andrewge8622/PCB_Coil_WPT/Hardware/Inductor Coil 2L/Renders/Inductor Coils.png

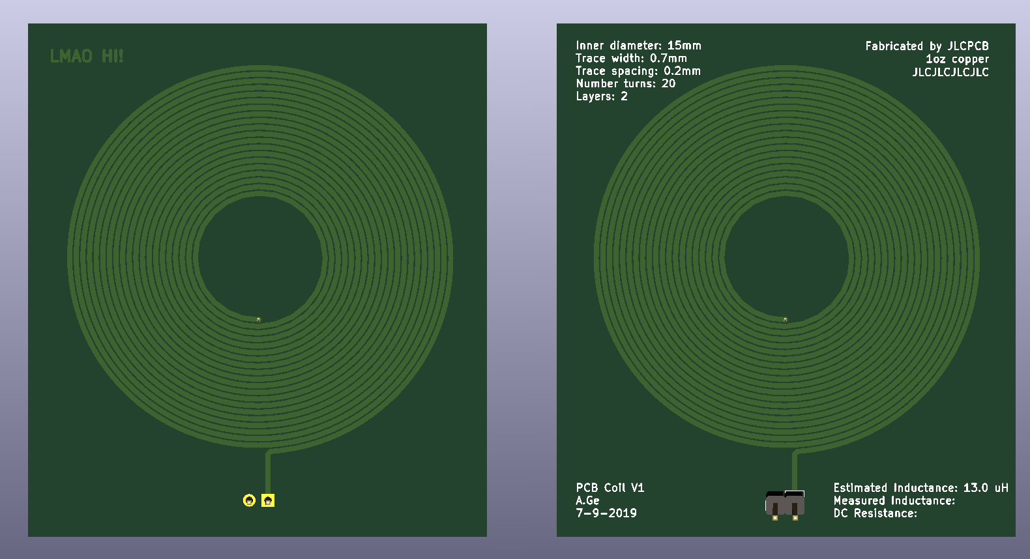
Hardware/Inductor Coil 2L/Renders/Inductor Coils.png
