andrewge8622/PCB_Coil_WPT/Hardware/Coil Driver/STEP models/WE-TPC_4818 (rev1).stp

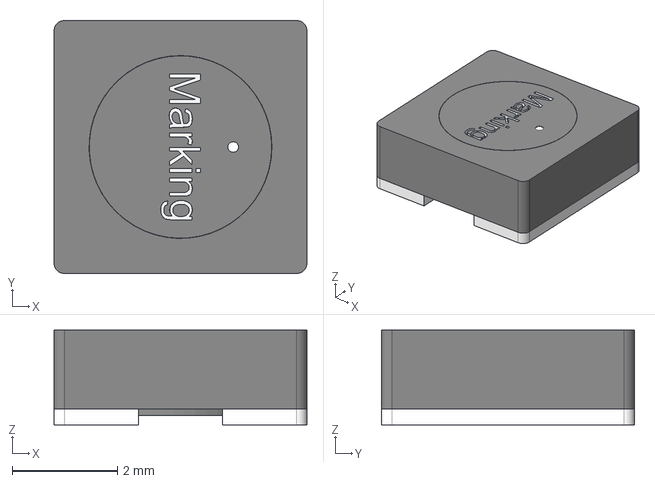
[picture p2: CAD file, 2020-12-25]
Hardware/Coil Driver/STEP models/WE-TPC_4818 (rev1).stp
4.80 x 4.80 x 1.80 mm
