andrewge8622/PCB_Coil_WPT/Hardware/WPT Receiver/STEP models/ECS-80-18-30-JGN-TR.STEP

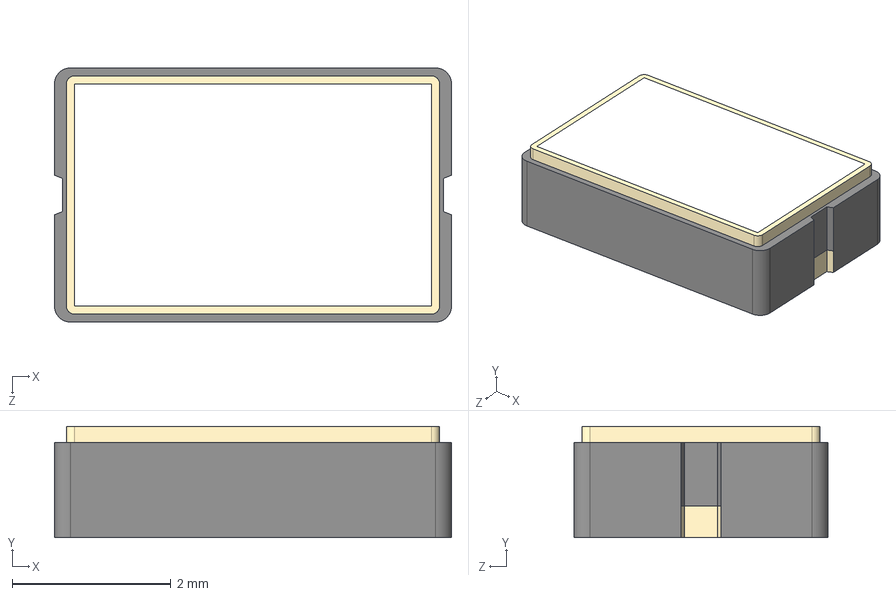
[picture p3: CAD file, 2020-12-27]
Hardware/WPT Receiver/STEP models/ECS-80-18-30-JGN-TR.STEP
5.00 x 1.40 x 3.20 mm
