andrewge8622/PCB_Coil_WPT/Hardware/Coil Driver/STEP models/CUI_DEVICES_PJ-102AH.step

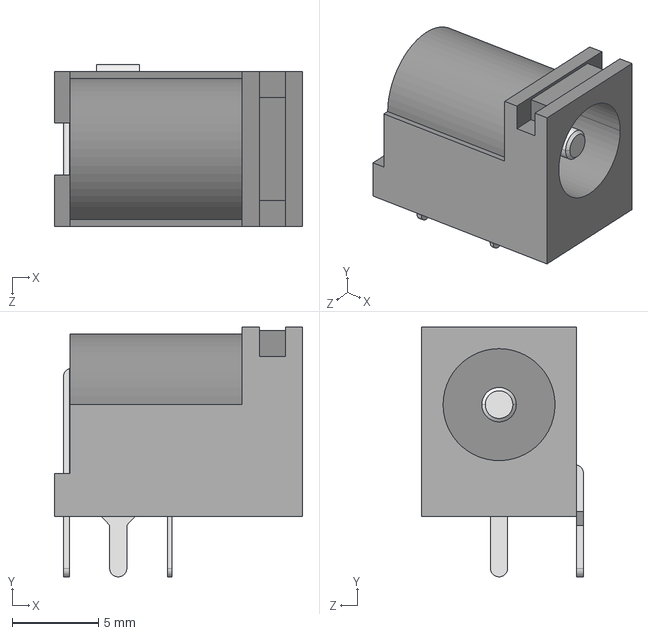
[picture p4: CAD file, 2020-12-25]
Hardware/Coil Driver/STEP models/CUI_DEVICES_PJ-102AH.step
14.4 x 14.5 x 9.40 mm
