andrewge8622/PCB_Coil_WPT/Hardware/WPT Receiver/STEP models/PTS647SN50SMTR2LFS.stp

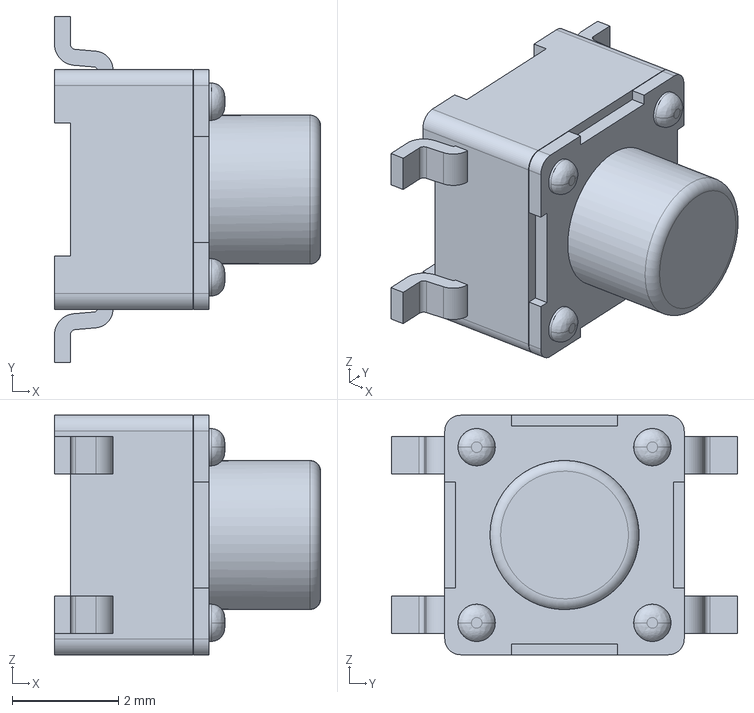
[picture p5: CAD file, 2020-12-25]
Hardware/WPT Receiver/STEP models/PTS647SN50SMTR2LFS.stp
5.00 x 6.50 x 4.50 mm
