andrewge8622/PCB_Coil_WPT/Hardware/Coil Driver/STEP models/ABM3B.STEP

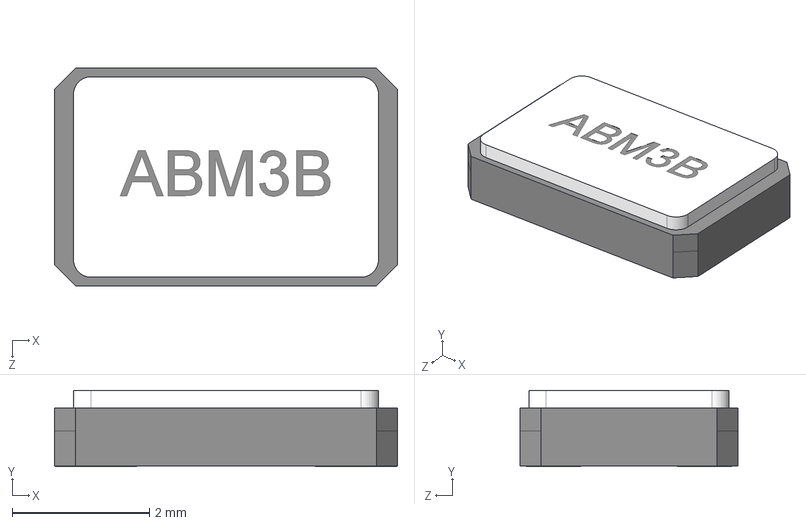
[picture p6: CAD file, 2020-12-25]
Hardware/Coil Driver/STEP models/ABM3B.STEP
5.00 x 1.11 x 3.18 mm
