andrewge8622/PCB_Coil_WPT/Hardware/Coil Driver/STEP models/16-2.STEP

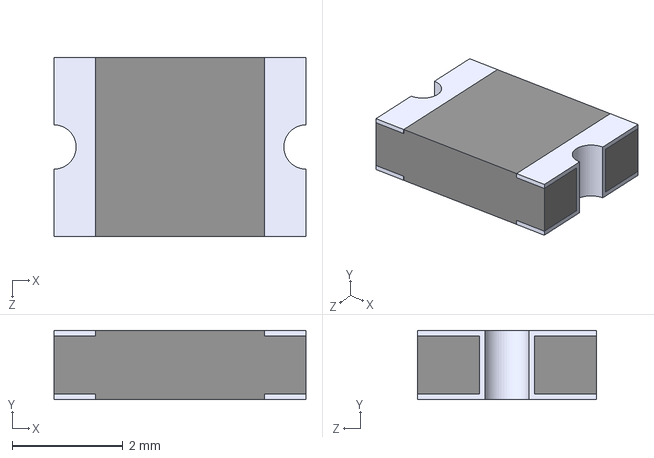
[picture p7: CAD file, 2020-12-10]
Hardware/Coil Driver/STEP models/16-2.STEP
4.55 x 1.25 x 3.24 mm
