andrewge8622/PCB_Coil_WPT/Hardware/Coil Driver/STEP models/DGD05473FN-7.stp

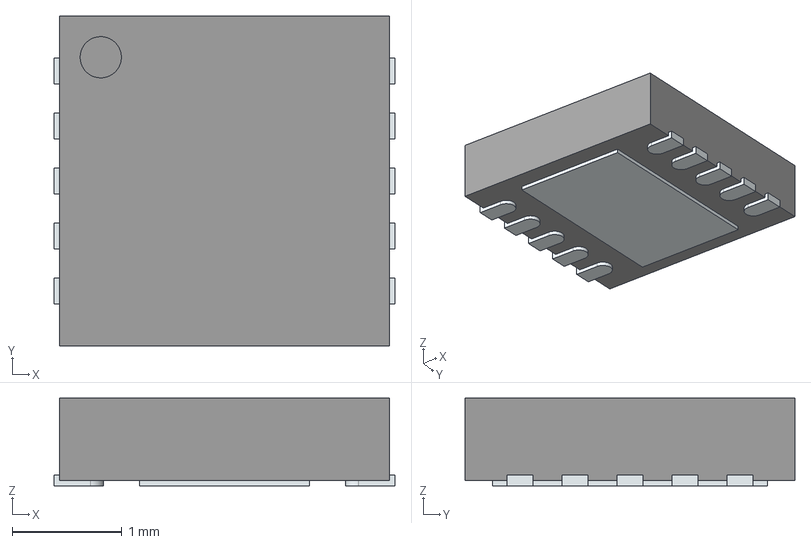
[picture p8: CAD file, 2020-11-12]
Hardware/Coil Driver/STEP models/DGD05473FN-7.stp
3.10 x 3.00 x 0.8 mm
ThermalPin
PinsArrayLR
