andrewge8622/PCB_Coil_WPT/Hardware/WPT Receiver/WPT Receiver.kicad_pcb

## KiCad design Hardware/WPT Receiver/WPT Receiver.kicad_pcb (2021-07-31)

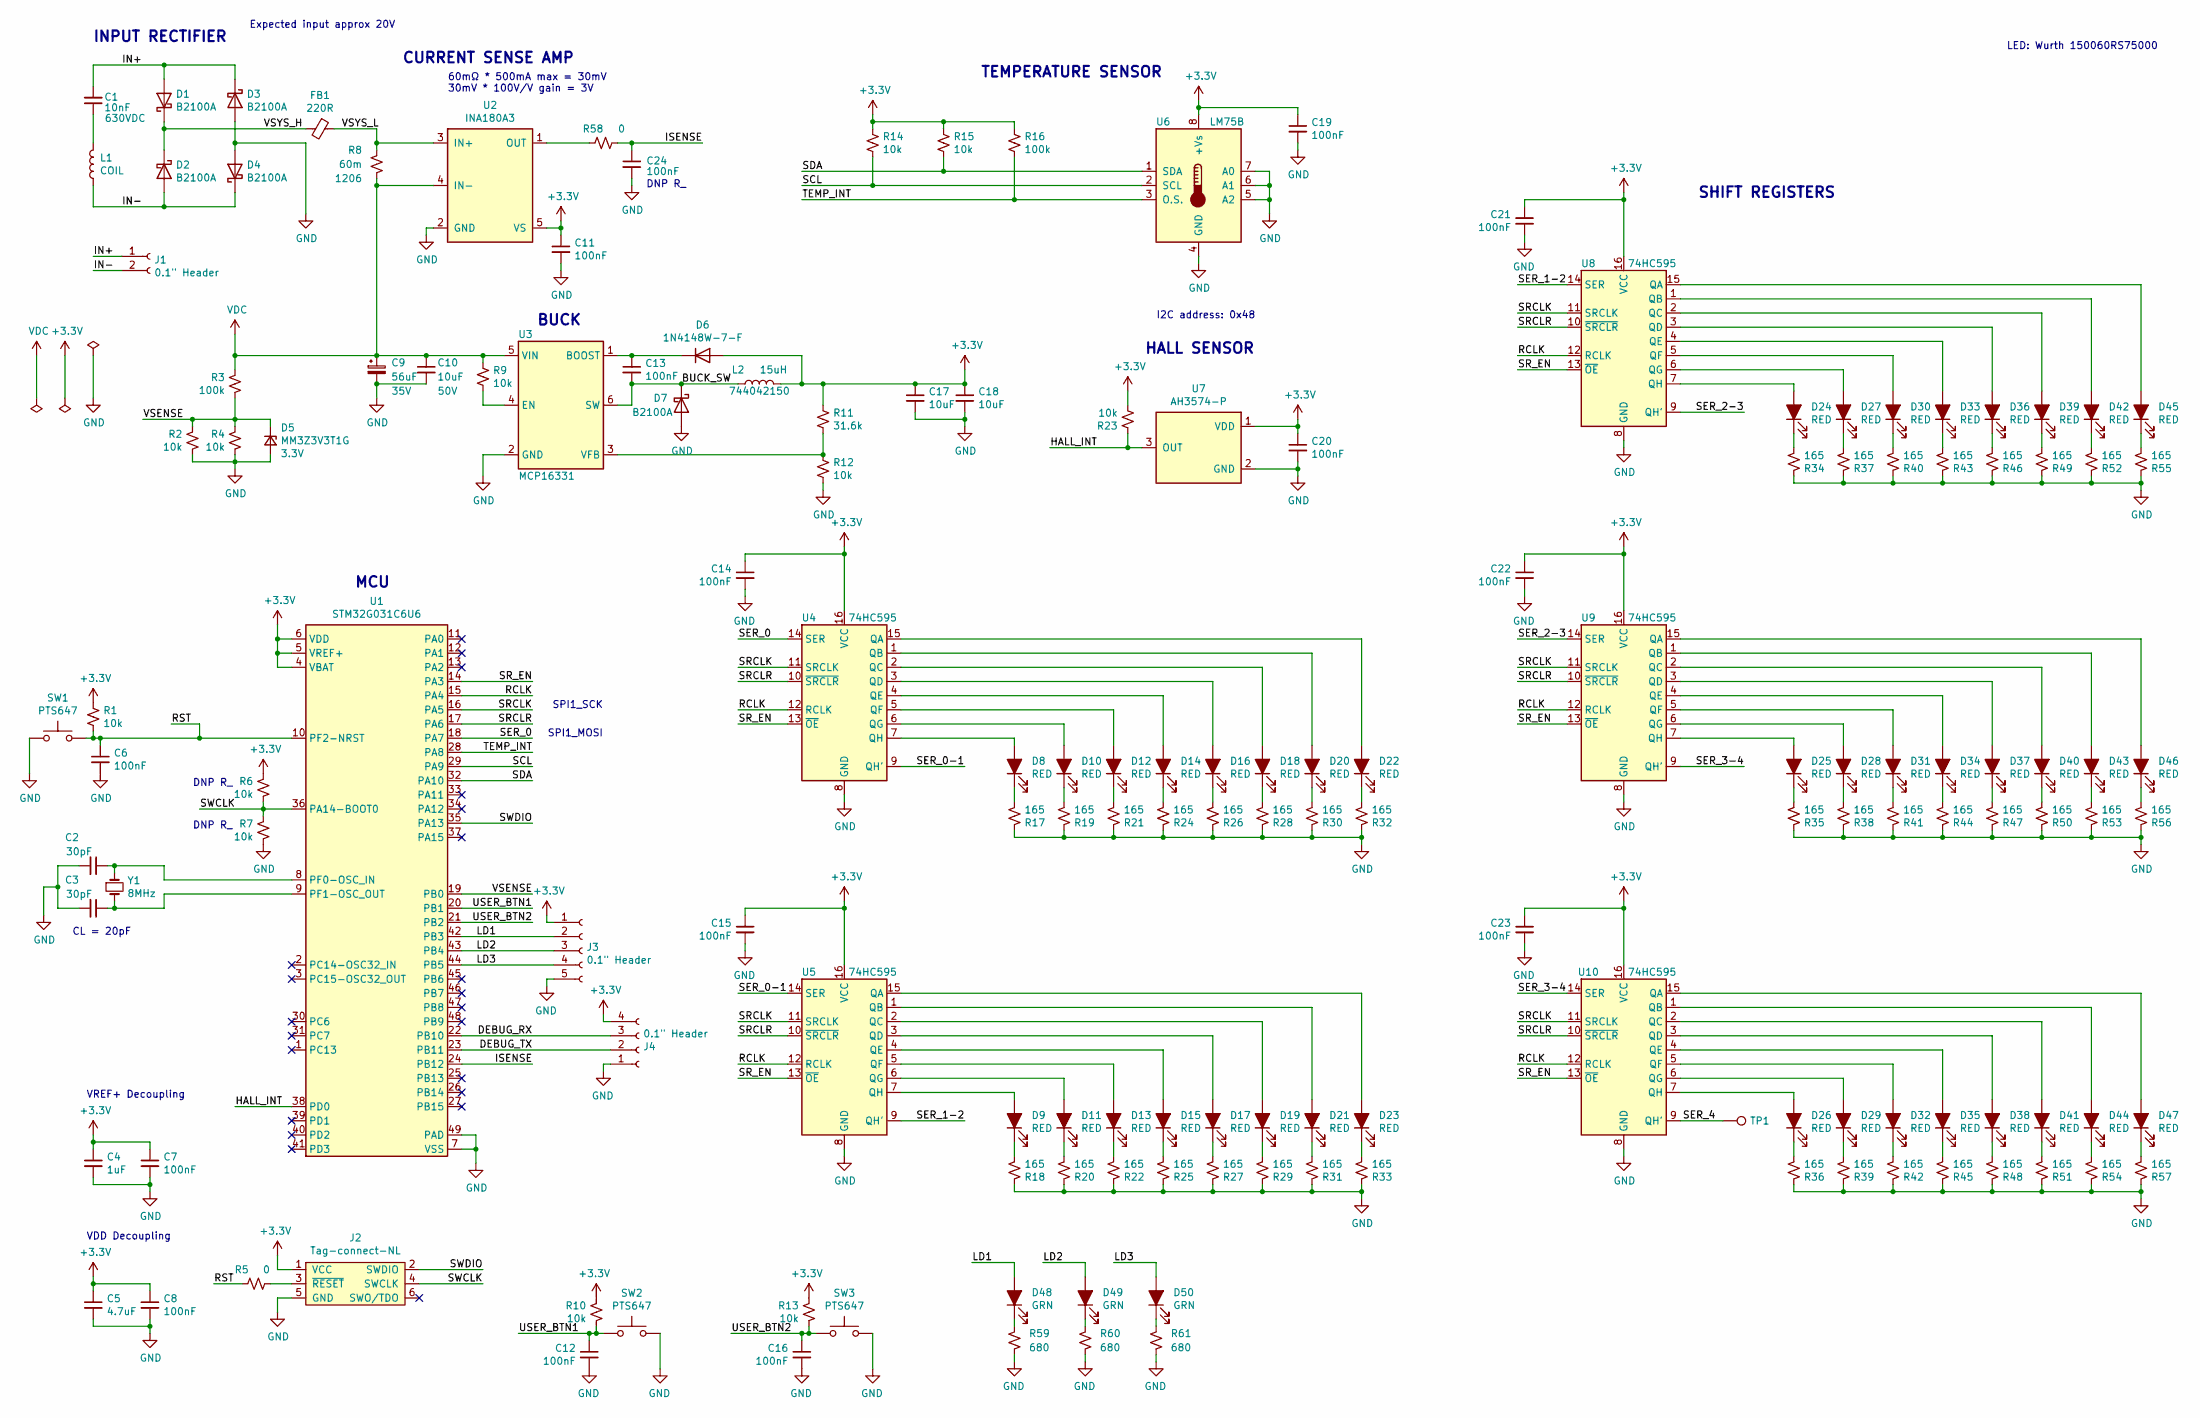
[picture p9: schematic WPT Receiver.sch, Wireless Power Receiver]

Parts:
C1: 10nF; C_Rect_L7.2mm_W8.5mm_P5.00mm_FKP2_FKP2_MKS2_MKP2; Voltage 630VDC
C2, C3: 30pF; C_0402_1005Metric
C4: 1uF; C_0603_1608Metric
C5: 4.7uF; C_0603_1608Metric
C6, C7, C8, C11, C12, C13, C14, C15, C16, C19, C20, C21, C22, C23, C24: 100nF; C_0402_1005Metric
C9: 56uF; CP_Elec_10x10; MPN EMVA630ADA560MJA0G
C10, C17, C18: 10uF; C_0603_1608Metric
D1, D2, D3, D4, D7: B2100A; D_SMA
D5: MM3Z3V3T1G; D_SOD-323; Voltage 3.3V
D6: 1N4148W-7-F; D_SOD-123
D8, D9, D10, D11, D12, D13, D14, D15, D16, D17, D18, D19, D20, D21, D22, D23, D24, D25, D26, D27, D28, D29, D30, D31, D32, D33, D34, D35, D36, D37, D38, D39, D40, D41, D42, D43, D44, D45, D46, D47: RED; LED_0603_1608Metric_Castellated
D48, D49, D50: GRN; LED_0603_1608Metric_Castellated; MPN 150060VS75000
FB1: 220R; L_0603_1608Metric
J1: 0.1\" Header; PinHeader_1x02_P2.54mm_Vertical
J2: Tag-connect-NL; TC2030-IDC-NL-FP
J3: 0.1\" Header; PinHeader_1x05_P2.54mm_Vertical
J4: 0.1\" Header; PinHeader_1x04_P2.54mm_Vertical
L1: COIL; PinHeader_2x01_P2.54mm_Vertical
L2: 15uH; 744042150; MPN 744042150
R1, R2, R4, R6, R7, R9, R10, R12, R13, R14, R15, R23: 10k; R_0603_1608Metric
R3, R16: 100k; R_0603_1608Metric
R5, R58: 0; R_0603_1608Metric
R8: 60m; R_1206_3216Metric
R11: 31.6k; R_0603_1608Metric
R17, R18, R19, R20, R21, R22, R24, R25, R26, R27, R28, R29, R30, R31, R32, R33, R34, R35, R36, R37, R38, R39, R40, R41, R42, R43, R44, R45, R46, R47, R48, R49, R50, R51, R52, R53, R54, R55, R56, R57: 165; R_0603_1608Metric
R59, R60, R61: 680; R_0603_1608Metric
SW1, SW2, SW3: PTS647
TP1: TestPoint; TestPoint_Pad_2.5x2.5mm
U1: STM32G031C6U6; QFN-48-1EP_7x7mm_P0.5mm_EP5.6x5.6mm
U2: INA180A3; SOT-23-5
U3: MCP16331; SOT-23-6
U4, U5, U8, U9, U10: 74HC595; SOIC-16_3.9x9.9mm_P1.27mm
U6: LM75B; SOIC-8_3.9x4.9mm_P1.27mm
U7: AH3574-P; TO-92Flat
Y1: 8MHz; Crystal_SMD_5032-2Pin_5.0x3.2mm

Connections:
+3V3: C4.1, C5.1, C7.1, C8.1, C11.1, C14.1, C15.1, C17.1, C18.1, C19.1, C20.1, C21.1, C22.1, C23.1, D6.2 (A), J2.1 (VCC), J3.1, J4.4, L2.2, R1.1, R6.2, R10.1, R11.1, R13.1, R14.1, R15.1, R16.1, R23.2, U1.4 (VBAT), U1.5 (VREF+), U1.6 (VDD), U2.5 (VS), U4.16 (VCC), U5.16 (VCC), U6.8 (+Vs), U7.1 (VDD), U8.16 (VCC), U9.16 (VCC), U10.16 (VCC)
/BUCK_SW: C13.2, D7.1 (K), L2.1, U3.6 (SW)
/DEBUG_RX: J4.3, U1.22 (PB10)
/DEBUG_TX: J4.2, U1.23 (PB11)
/HALL_INT: R23.1, U1.38 (PD0), U7.3 (OUT)
/IN+: C1.2, D1.2 (A), D3.1 (K), J1.1
/IN-: D2.2 (A), D4.1 (K), J1.2, L1.1
/ISENSE: C24.1, R58.1, U1.24 (PB12)
/LD1: D48.2 (A), J3.2, U1.42 (PB3)
/LD2: D49.2 (A), J3.3, U1.43 (PB4)
/LD3: D50.2 (A), J3.4, U1.44 (PB5)
/RCLK: U1.15 (PA4), U4.12 (RCLK), U5.12 (RCLK), U8.12 (RCLK), U9.12 (RCLK), U10.12 (RCLK)
/RST: C6.1, R1.2, R5.1, SW1.2, U1.10 (PF2-NRST)
/SCL: R14.2, U1.29 (PA9), U6.2 (SCL)
/SDA: R15.2, U1.32 (PA10), U6.1 (SDA)
/SER_0: U1.18 (PA7), U4.14 (SER)
/SER_0-1: U4.9 (QH'), U5.14 (SER)
/SER_1-2: U5.9 (QH'), U8.14 (SER)
/SER_2-3: U8.9 (QH'), U9.14 (SER)
/SER_3-4: U9.9 (QH'), U10.14 (SER)
/SER_4: TP1.1, U10.9 (QH')
/SRCLK: U1.16 (PA5), U4.11 (SRCLK), U5.11 (SRCLK), U8.11 (SRCLK), U9.11 (SRCLK), U10.11 (SRCLK)
/SRCLR: U1.17 (PA6), U4.10 (~SRCLR), U5.10 (~SRCLR), U8.10 (~SRCLR), U9.10 (~SRCLR), U10.10 (~SRCLR)
/SR_EN: U1.14 (PA3), U4.13 (~OE), U5.13 (~OE), U8.13 (~OE), U9.13 (~OE), U10.13 (~OE)
/SWCLK: J2.4 (SWCLK), R6.1, R7.2, U1.36 (PA14-BOOT0)
/SWDIO: J2.2 (SWDIO), U1.35 (PA13)
/TEMP_INT: R16.2, U1.28 (PA8), U6.3 (O.S.)
/USER_BTN1: C12.1, R10.2, SW2.2, U1.20 (PB1)
/USER_BTN2: C16.1, R13.2, SW3.2, U1.21 (PB2)
/VSENSE: D5.1 (K), R2.1, R3.2, R4.1, U1.19 (PB0)
/VSYS_H: D1.1 (K), D2.1 (K), FB1.2
/VSYS_L: FB1.1, R8.1, U2.3 (IN+)
GND: C2.2, C3.2, C4.2, C5.2, C6.2, C7.2, C8.2, C9.2, C10.2, C11.2, C12.2, C14.2, C15.2, C16.2, C17.2, C18.2, C19.2, C20.2, C21.2, C22.2, C23.2, C24.2, D3.2 (A), D4.2 (A), D5.2 (A), D7.2 (A), J2.5 (GND), J3.5, J4.1, R2.2, R4.2, R7.1, R12.2, R17.2, R18.2, R19.2, R20.2, R21.2, R22.2, R24.2, R25.2, R26.2, R27.2, R28.2, R29.2, R30.2, R31.2, R32.2, R33.2, R34.2, R35.2, R36.2, R37.2, R38.2, R39.2, R40.2, R41.2, R42.2, R43.2, R44.2, R45.2, R46.2, R47.2, R48.2, R49.2, R50.2, R51.2, R52.2, R53.2, R54.2, R55.2, R56.2, R57.2, R59.2, R60.2, R61.2, SW1.1, SW2.1, SW3.1, U1.7 (VSS), U1.49 (PAD), U2.2 (GND), U3.2 (GND), U4.8 (GND), U5.8 (GND), U6.4 (GND), U6.5 (A2), U6.6 (A1), U6.7 (A0), U7.2 (GND), U8.8 (GND), U9.8 (GND), U10.8 (GND)
unnamed: C1.1, L1.2
unnamed: C2.1, U1.8 (PF0-OSC_IN), Y1.1
unnamed: C3.1, U1.9 (PF1-OSC_OUT), Y1.2
unnamed: C13.1, D6.1 (K), U3.1 (BOOST)
unnamed: D8.1 (K), R17.1
unnamed: D8.2 (A), U4.7 (QH)
unnamed: D9.1 (K), R18.1
unnamed: D9.2 (A), U5.7 (QH)
unnamed: D10.1 (K), R19.1
unnamed: D10.2 (A), U4.6 (QG)
unnamed: D11.1 (K), R20.1
unnamed: D11.2 (A), U5.6 (QG)
unnamed: D12.1 (K), R21.1
unnamed: D12.2 (A), U4.5 (QF)
unnamed: D13.1 (K), R22.1
unnamed: D13.2 (A), U5.5 (QF)
unnamed: D14.1 (K), R24.1
unnamed: D14.2 (A), U4.4 (QE)
unnamed: D15.1 (K), R25.1
unnamed: D15.2 (A), U5.4 (QE)
unnamed: D16.1 (K), R26.1
unnamed: D16.2 (A), U4.3 (QD)
unnamed: D17.1 (K), R27.1
unnamed: D17.2 (A), U5.3 (QD)
unnamed: D18.1 (K), R28.1
unnamed: D18.2 (A), U4.2 (QC)
unnamed: D19.1 (K), R29.1
unnamed: D19.2 (A), U5.2 (QC)
unnamed: D20.1 (K), R30.1
unnamed: D20.2 (A), U4.1 (QB)
unnamed: D21.1 (K), R31.1
unnamed: D21.2 (A), U5.1 (QB)
unnamed: D22.1 (K), R32.1
unnamed: D22.2 (A), U4.15 (QA)
unnamed: D23.1 (K), R33.1
unnamed: D23.2 (A), U5.15 (QA)
unnamed: D24.1 (K), R34.1
unnamed: D24.2 (A), U8.7 (QH)
unnamed: D25.1 (K), R35.1
unnamed: D25.2 (A), U9.7 (QH)
unnamed: D26.1 (K), R36.1
unnamed: D26.2 (A), U10.7 (QH)
unnamed: D27.1 (K), R37.1
unnamed: D27.2 (A), U8.6 (QG)
unnamed: D28.1 (K), R38.1
unnamed: D28.2 (A), U9.6 (QG)
unnamed: D29.1 (K), R39.1
unnamed: D29.2 (A), U10.6 (QG)
unnamed: D30.1 (K), R40.1
unnamed: D30.2 (A), U8.5 (QF)
unnamed: D31.1 (K), R41.1
unnamed: D31.2 (A), U9.5 (QF)
unnamed: D32.1 (K), R42.1
unnamed: D32.2 (A), U10.5 (QF)
unnamed: D33.1 (K), R43.1
unnamed: D33.2 (A), U8.4 (QE)
unnamed: D34.1 (K), R44.1
unnamed: D34.2 (A), U9.4 (QE)
unnamed: D35.1 (K), R45.1
unnamed: D35.2 (A), U10.4 (QE)
unnamed: D36.1 (K), R46.1
unnamed: D36.2 (A), U8.3 (QD)
unnamed: D37.1 (K), R47.1
unnamed: D37.2 (A), U9.3 (QD)
unnamed: D38.1 (K), R48.1
unnamed: D38.2 (A), U10.3 (QD)
unnamed: D39.1 (K), R49.1
unnamed: D39.2 (A), U8.2 (QC)
unnamed: D40.1 (K), R50.1
unnamed: D40.2 (A), U9.2 (QC)
unnamed: D41.1 (K), R51.1
unnamed: D41.2 (A), U10.2 (QC)
unnamed: D42.1 (K), R52.1
unnamed: D42.2 (A), U8.1 (QB)
unnamed: D43.1 (K), R53.1
unnamed: D43.2 (A), U9.1 (QB)
unnamed: D44.1 (K), R54.1
unnamed: D44.2 (A), U10.1 (QB)
unnamed: D45.1 (K), R55.1
unnamed: D45.2 (A), U8.15 (QA)
unnamed: D46.1 (K), R56.1
unnamed: D46.2 (A), U9.15 (QA)
unnamed: D47.1 (K), R57.1
unnamed: D47.2 (A), U10.15 (QA)
unnamed: D48.1 (K), R59.1
unnamed: D49.1 (K), R60.1
unnamed: D50.1 (K), R61.1
unnamed: J2.3 (~RESET), R5.2
unnamed: R9.2, U3.4 (EN)
unnamed: R11.2, R12.1, U3.3 (VFB)
unnamed: R58.2, U2.1 (OUT)
VDC: C9.1, C10.1, R3.1, R8.2, R9.1, U2.4 (IN-), U3.5 (VIN)

Notes on the sheet:
DNP R_
VDD Decoupling
VREF+ Decoupling
Expected input approx 20V
CL = 20pF
60mΩ * 500mA max = 30mV 30mV * 100V/V gain = 3V
I2C address: 0x48
SPI1_SCK
SPI1_MOSI
LED: Wurth 150060RS75000
HALL SENSOR
TEMPERATURE SENSOR
INPUT RECTIFIER
CURRENT SENSE AMP
BUCK
MCU
SHIFT REGISTERS

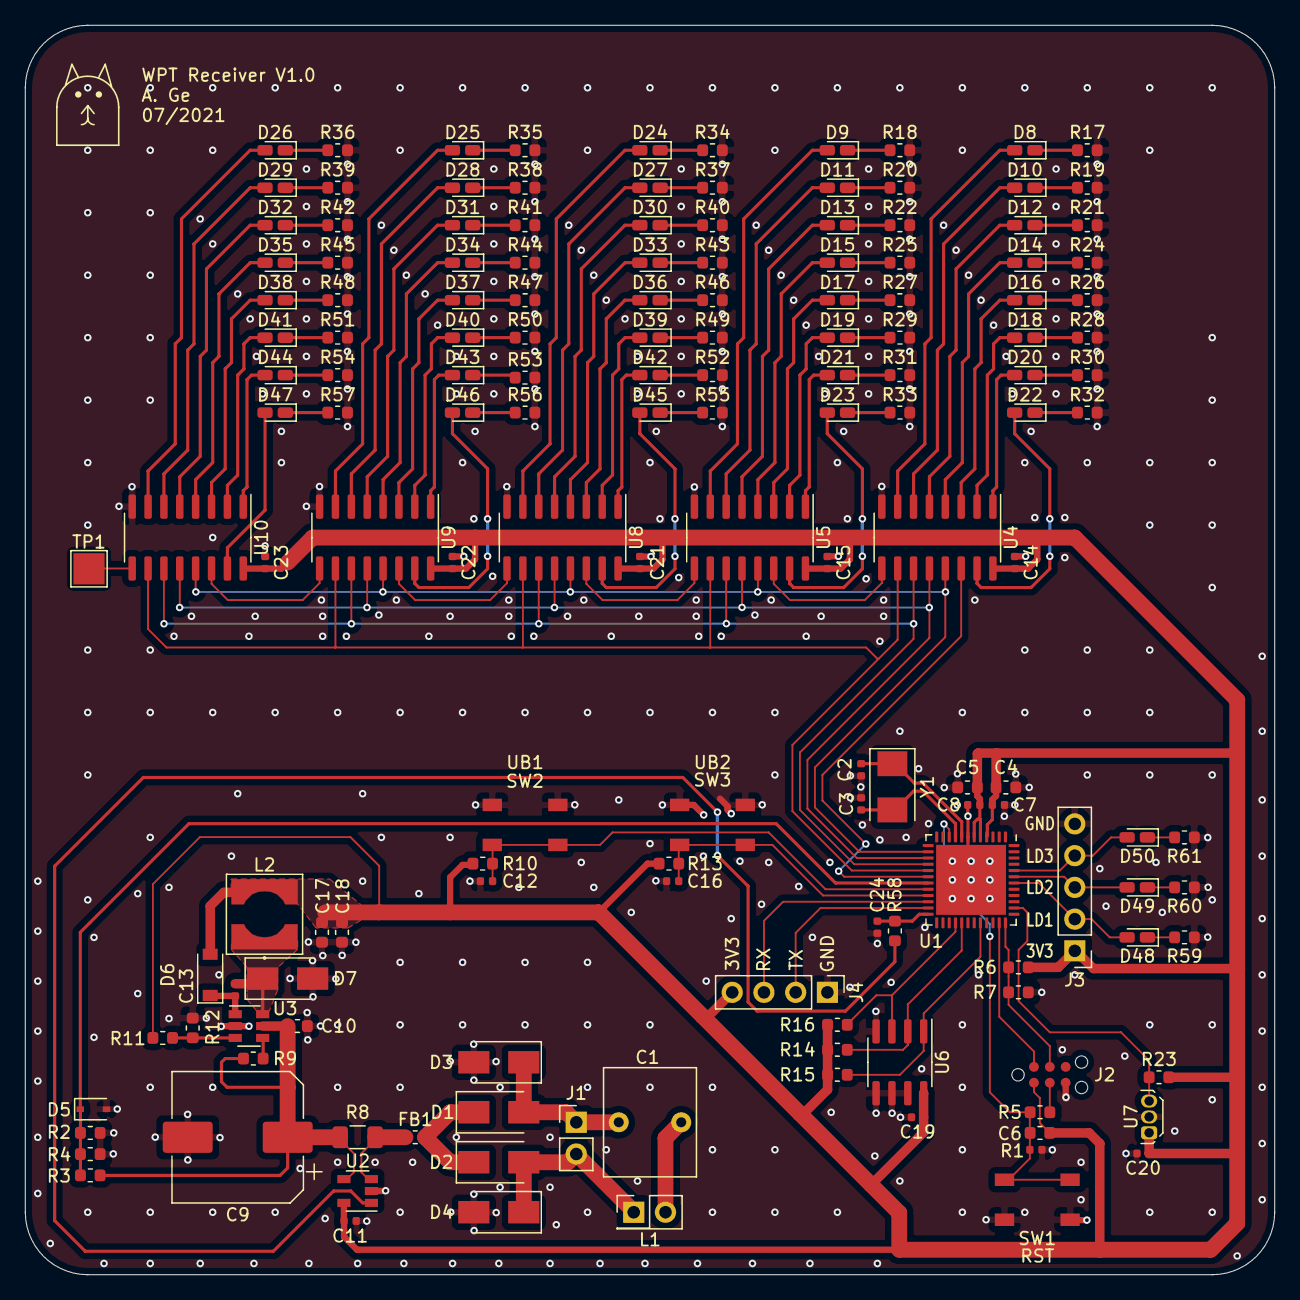
[picture p10: board WPT Receiver.kicad_pcb from above]

Board: 2 copper layers, 100.0 x 100.0 mm, 157 parts (0 on the bottom side), 125 nets.
