andrewge8622/PCB_Coil_WPT/Hardware/Coil Driver/Coil Driver.kicad_pcb

## KiCad design Hardware/Coil Driver/Coil Driver.kicad_pcb (2021-06-06)

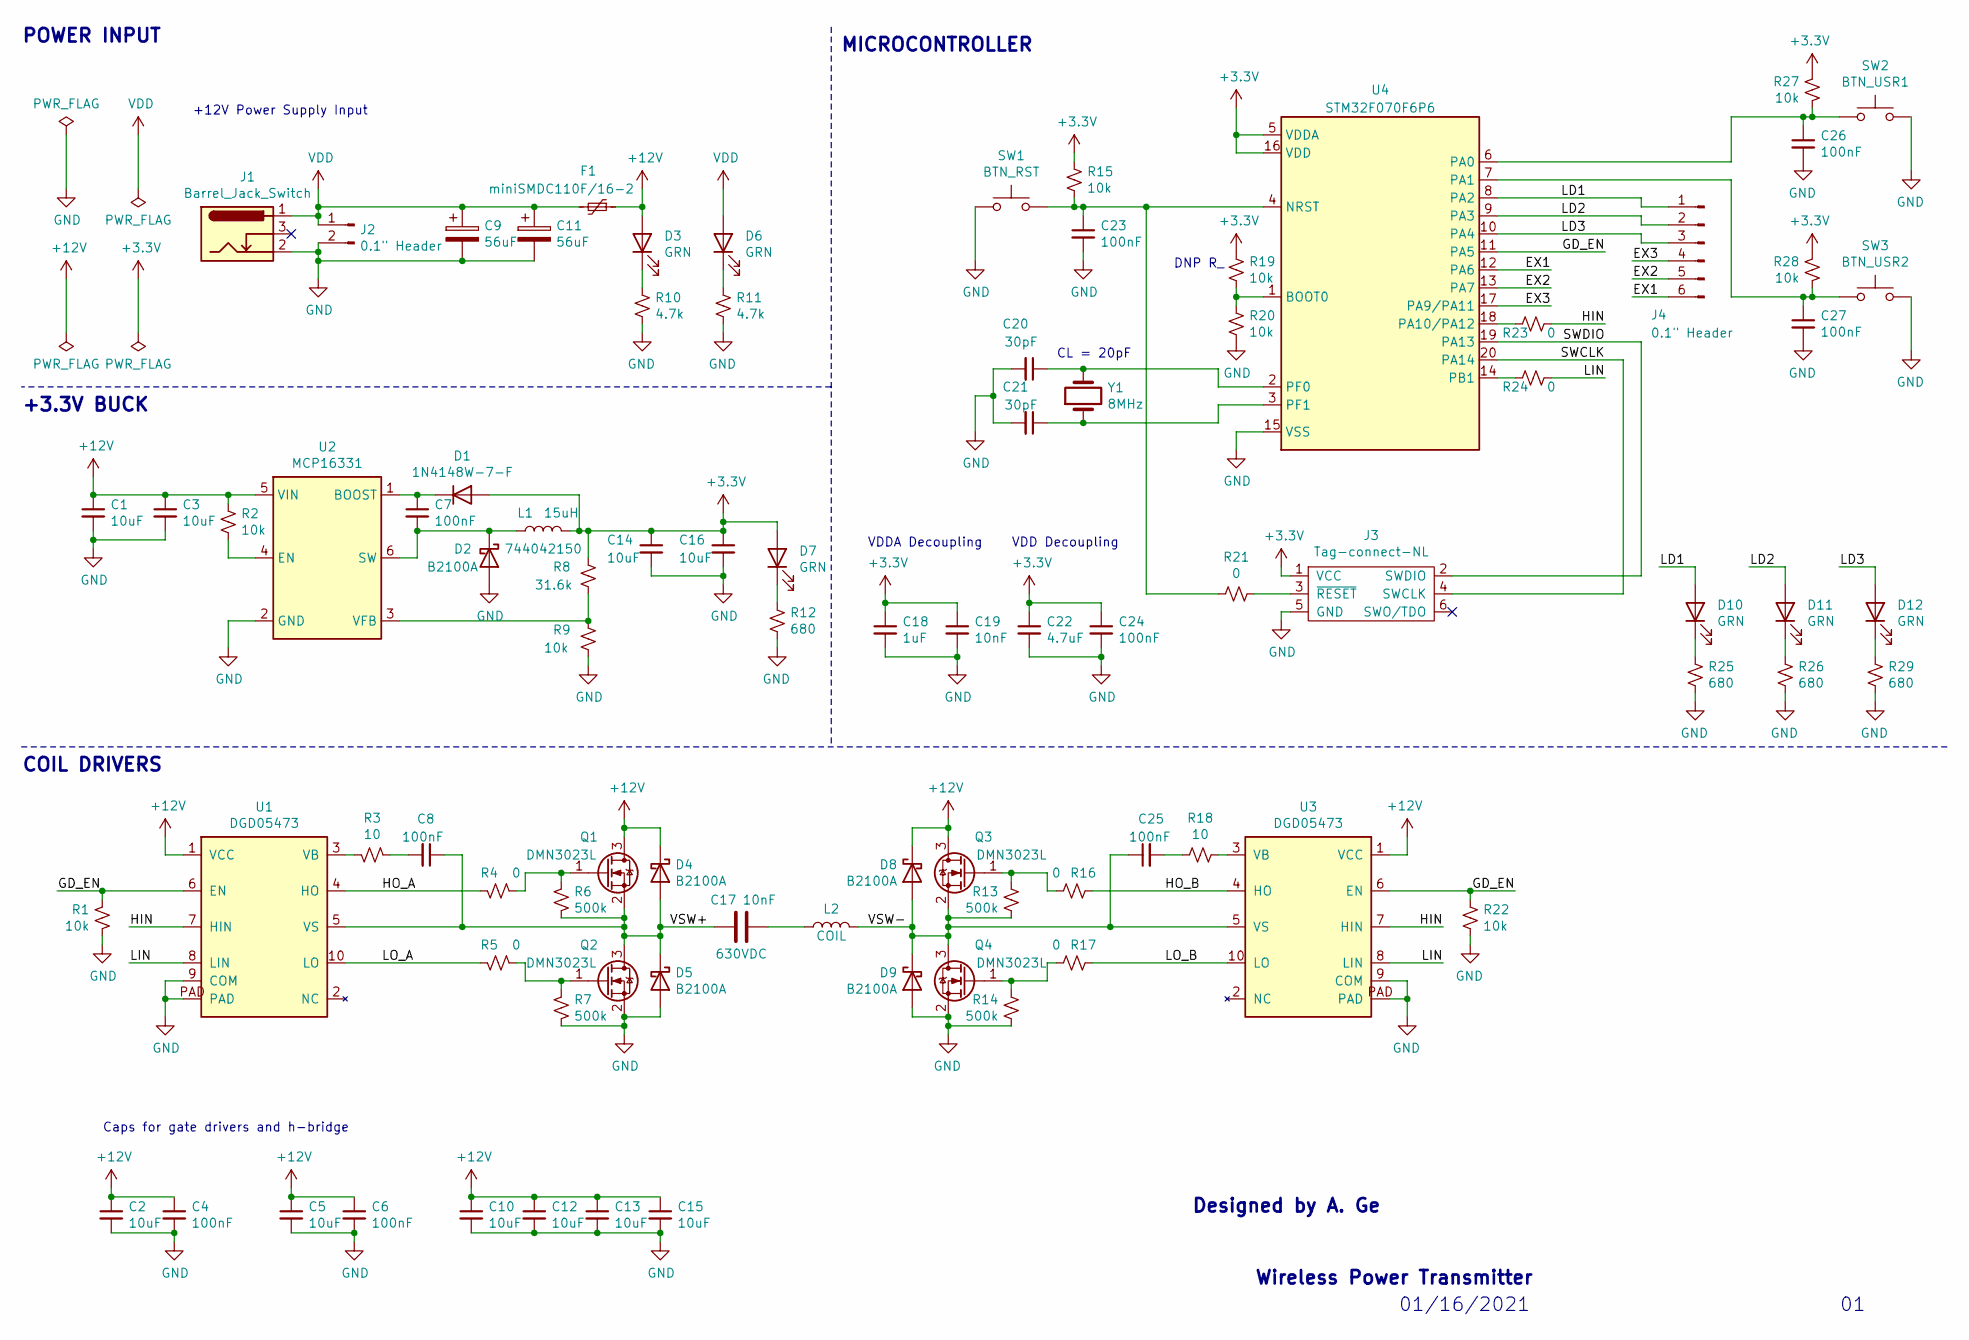
[picture p11: schematic Coil Driver.sch]

Parts:
C1, C2, C3, C5, C10, C12, C13, C14, C15, C16: 10uF; C_0603_1608Metric
C4, C6, C7, C8, C23, C24, C25, C26, C27: 100nF; C_0402_1005Metric
C9, C11: 56uF; CP_Elec_6.3x7.7
C17: 10nF; C_Rect_L7.2mm_W8.5mm_P5.00mm_FKP2_FKP2_MKS2_MKP2; Voltage Rating 630VDC; MPN FKP2J021001L00JSC9
C18: 1uF; C_0603_1608Metric
C19: 10nF; C_0402_1005Metric
C20, C21: 30pF; C_0402_1005Metric
C22: 4.7uF; C_0603_1608Metric
D1: 1N4148W-7-F; D_SOD-123
D2, D4, D5, D8, D9: B2100A; D_SMA
D3, D6, D7, D10, D11, D12: GRN; LED_0603_1608Metric; MPN 150060VS75000
F1: miniSMDC110F/16-2; miniSMDC110F_16-2
J1: Barrel_Jack_Switch; BarrelJack_CUI_PJ-102AH_Horizontal
J2: 0.1\" Header; PinHeader_1x02_P2.54mm_Vertical
J3: Tag-connect-NL; TC2030-IDC-NL-FP
J4: 0.1\" Header; PinHeader_1x06_P2.54mm_Vertical
L1: 15uH; 744042150; MPN 744042150
L2: COIL; PinSocket_1x02_P2.54mm_Vertical
Q1, Q2, Q3, Q4: DMN3023L; SOT-23
R1, R2, R9, R15, R19, R20, R22, R27, R28: 10k; R_0603_1608Metric
R3, R18: 10; R_0805_2012Metric
R4, R5, R16, R17, R21, R23, R24: 0; R_0603_1608Metric
R6, R7, R13, R14: 500k; R_0603_1608Metric
R8: 31.6k; R_0603_1608Metric
R10, R11: 4.7k; R_0603_1608Metric
R12, R25, R26, R29: 680; R_0603_1608Metric
SW1: BTN_RST; PTS647
SW2: BTN_USR1; PTS647
SW3: BTN_USR2; PTS647
U1, U3: DGD05473; W-DFN3030-10
U2: MCP16331; SOT-23-6
U4: STM32F070F6P6; TSSOP-20_4.4x6.5mm_P0.65mm
Y1: 8MHz; Crystal_SMD_5032-2Pin_5.0x3.2mm

Connections:
+3V3: C14.1, C16.1, C18.1, C19.1, C22.1, C24.1, D1.2 (A), D7.2 (A), J3.1 (VCC), L1.2, R8.1, R15.1, R19.1, R27.1, R28.1, U4.5 (VDDA), U4.16 (VDD)
+12V: C1.1, C2.1, C3.1, C4.1, C5.1, C6.1, C10.1, C12.1, C13.1, C15.1, D3.2 (A), D4.1 (K), D8.1 (K), F1.1, Q1.3 (D), Q3.3 (D), R2.1, U1.1 (VCC), U2.5 (VIN), U3.1 (VCC)
/EX1: J4.6, U4.12 (PA6)
/EX2: J4.5, U4.13 (PA7)
/EX3: J4.4, U4.17 (PA9/PA11)
/GD_EN: R1.2, R22.2, U1.6 (EN), U3.6 (EN), U4.11 (PA5)
/HIN: R23.1, U1.7 (HIN), U3.7 (HIN)
/HO_A: R4.1, U1.4 (HO)
/HO_B: R16.1, U3.4 (HO)
/LD1: D10.2 (A), J4.1, U4.8 (PA2)
/LD2: D11.2 (A), J4.2, U4.9 (PA3)
/LD3: D12.2 (A), J4.3, U4.10 (PA4)
/LIN: R24.1, U1.8 (LIN), U3.8 (LIN)
/LO_A: R5.1, U1.10 (LO)
/LO_B: R17.1, U3.10 (LO)
/SWCLK: J3.4 (SWCLK), U4.20 (PA14)
/SWDIO: J3.2 (SWDIO), U4.19 (PA13)
/VSW+: C8.1, C17.2, D4.2 (A), D5.1 (K), Q1.2 (S), Q2.3 (D), R6.2, U1.5 (VS)
/VSW-: C25.1, D8.2 (A), D9.1 (K), L2.2, Q3.2 (S), Q4.3 (D), R13.2, U3.5 (VS)
GND: C1.2, C2.2, C3.2, C4.2, C5.2, C6.2, C9.2, C10.2, C11.2, C12.2, C13.2, C14.2, C15.2, C16.2, C18.2, C19.2, C20.2, C21.2, C22.2, C23.2, C24.2, C26.2, C27.2, D2.2 (A), D5.2 (A), D9.2 (A), J1.2, J2.2, J3.5 (GND), Q2.2 (S), Q4.2 (S), R1.1, R7.2, R9.2, R10.2, R11.2, R12.2, R14.2, R20.2, R22.1, R25.2, R26.2, R29.2, SW1.1, SW2.1, SW3.1, U1.9 (COM), U1.PAD, U2.2 (GND), U3.9 (COM), U3.PAD, U4.15 (VSS)
unnamed: C7.1, D1.1 (K), U2.1 (BOOST)
unnamed: C7.2, D2.1 (K), L1.1, U2.6 (SW)
unnamed: C8.2, R3.2
unnamed: C17.1, L2.1
unnamed: C20.1, U4.2 (PF0), Y1.2
unnamed: C21.1, U4.3 (PF1), Y1.1
unnamed: C23.1, R15.2, R21.2, SW1.2, U4.4 (NRST)
unnamed: C25.2, R18.2
unnamed: C26.1, R27.2, SW2.2, U4.6 (PA0)
unnamed: C27.1, R28.2, SW3.2, U4.7 (PA1)
unnamed: D3.1 (K), R10.1
unnamed: D6.1 (K), R11.1
unnamed: D7.1 (K), R12.1
unnamed: D10.1 (K), R25.1
unnamed: D11.1 (K), R26.1
unnamed: D12.1 (K), R29.1
unnamed: J3.3 (~RESET), R21.1
unnamed: Q1.1 (G), R4.2, R6.1
unnamed: Q2.1 (G), R5.2, R7.1
unnamed: Q3.1 (G), R13.1, R16.2
unnamed: Q4.1 (G), R14.1, R17.2
unnamed: R2.2, U2.4 (EN)
unnamed: R3.1, U1.3 (VB)
unnamed: R8.2, R9.1, U2.3 (VFB)
unnamed: R18.1, U3.3 (VB)
unnamed: R19.2, R20.1, U4.1 (BOOT0)
unnamed: R23.2, U4.18 (PA10/PA12)
unnamed: R24.2, U4.14 (PB1)
VDD: C9.1, C11.1, D6.2 (A), F1.2, J1.1, J2.1

Notes on the sheet:
Caps for gate drivers and h-bridge
DNP R_
VDDA Decoupling
VDD Decoupling
+12V Power Supply Input
Designed by A. Ge
Wireless Power Transmitter
01/16/2021
MICROCONTROLLER
POWER INPUT
+3.3V BUCK
COIL DRIVERS
CL = 20pF

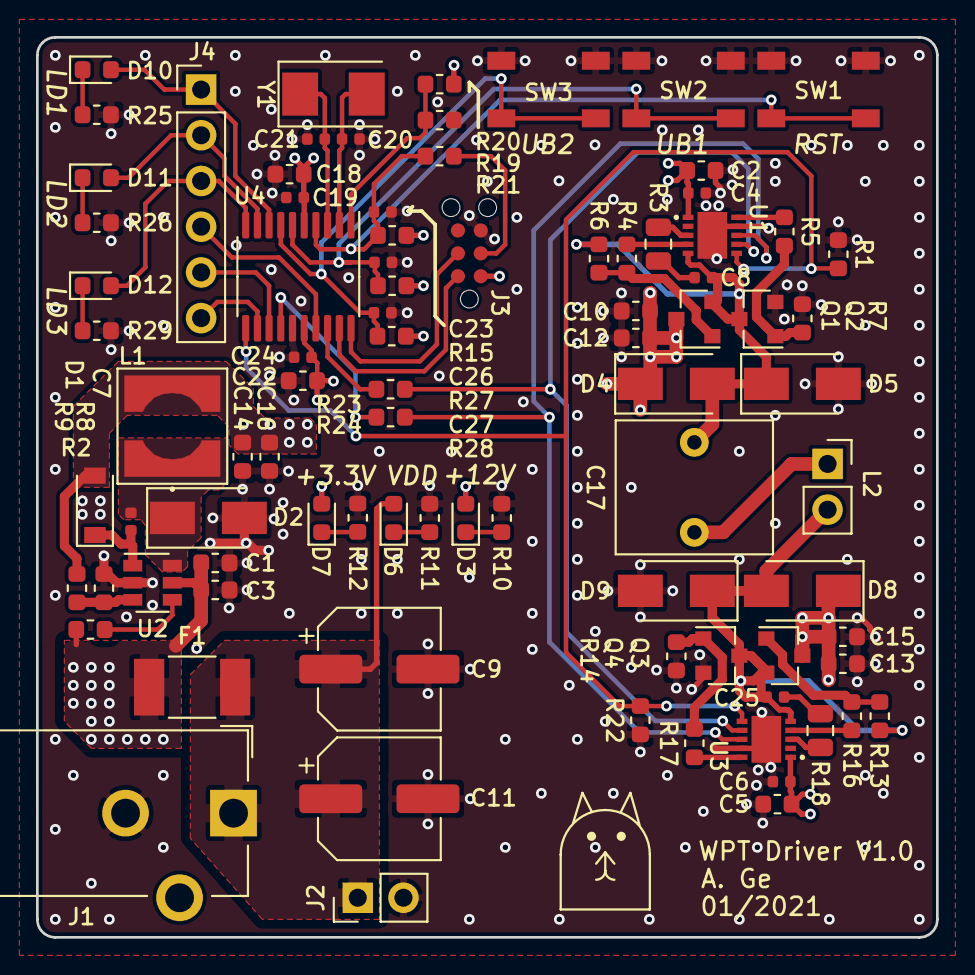
[picture p12: board Coil Driver.kicad_pcb from above]

Board: 4 copper layers, 50.0 x 50.0 mm, 87 parts (0 on the bottom side), 49 nets.
