andrewge8622/PCB_Coil_WPT/Firmware/WPT_Receiver/Core/Src/main.c

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
/* Includes ------------------------------------------------------------------*/
#include "main.h"

/* USER CODE BEGIN Includes */
#include "string.h"
#include <stdio.h>
#include "SN74HC595.h"

/* USER CODE END Includes */

ADC_HandleTypeDef hadc1;

I2C_HandleTypeDef hi2c1;

UART_HandleTypeDef hlpuart1;
DMA_HandleTypeDef hdma_lpuart1_rx;

SPI_HandleTypeDef hspi1;

TIM_HandleTypeDef htim2;

/* USER CODE BEGIN PV */

static uint16_t BlinkyPin;
static uint8_t BlinkyEn;

/* USER CODE END PV */

void SystemClock_Config(void);
static void MX_GPIO_Init(void);
static void MX_DMA_Init(void);
static void MX_ADC1_Init(void);
static void MX_I2C1_Init(void);
static void MX_LPUART1_UART_Init(void);
static void MX_SPI1_Init(void);
static void MX_TIM2_Init(void);
/* USER CODE BEGIN PFP */
static void ReverseRxIntoTx(void);
/* USER CODE END PFP */

/* USER CODE BEGIN 0 */
#define RX_BUFFER_SIZE 20
#define TX_BUFFER_SIZE 100
#define MAIN_BUFFER_SIZE 40

uint8_t DebugRxBuffer[RX_BUFFER_SIZE]; 
uint8_t DebugTxData[TX_BUFFER_SIZE] = "DEFAULT\r\n";
uint8_t MainDataBuffer[MAIN_BUFFER_SIZE];

uint8_t OldPos = 0;
uint8_t NewPos = 0;
uint8_t RxDataLength = 0;
uint8_t RxDataFlag = 0;

uint32_t ADC_CurrentReading = 0;

/* USER CODE END 0 */

/**
  * @brief  The application entry point.
  * @retval int
  */
int main(void)
{
  /* MCU Configuration--------------------------------------------------------*/

  /* Reset of all peripherals, Initializes the Flash interface and the Systick. */
  HAL_Init();

  /* Configure the system clock */
  SystemClock_Config();

  /* Initialize all configured peripherals */
  MX_GPIO_Init();
  MX_DMA_Init();
  MX_ADC1_Init();
  MX_I2C1_Init();
  MX_LPUART1_UART_Init();
  MX_SPI1_Init();
  MX_TIM2_Init();
  /* USER CODE BEGIN 2 */
	
	BlinkyPin = GPIO_PIN_3;
	BlinkyEn = 1;
	
	HAL_UARTEx_ReceiveToIdle_DMA(&hlpuart1, DebugRxBuffer, RX_BUFFER_SIZE);
	__HAL_DMA_DISABLE_IT(&hdma_lpuart1_rx, DMA_IT_HT);
	
	// Disable shift register output (active low) so LEDs don't turn on
	HAL_TIM_PWM_Start(&htim2, TIM_CHANNEL_4);
	SN74HC595_Init();
	
	// HAL_UART_Receive_DMA(&hlpuart1, DebugRxData, 20);
	
	HAL_UART_Transmit(&hlpuart1, DebugTxData, 9, 100);
	
  /* USER CODE END 2 */

  /* Infinite loop */
  /* USER CODE BEGIN WHILE */
  while (1)
  {
		HAL_ADC_Start(&hadc1);
		
		if (BlinkyEn)
		{
			HAL_GPIO_TogglePin(GPIOB, BlinkyPin);
			HAL_Delay(500);
		}
		else
			HAL_GPIO_WritePin(GPIOB, BlinkyPin, GPIO_PIN_RESET);
		
		if (RxDataFlag) 
		{
			ReverseRxIntoTx();
			HAL_UART_Transmit(&hlpuart1, DebugTxData, RxDataLength, 100);
			RxDataFlag = 0;
		}
		
		if(HAL_ADC_PollForConversion(&hadc1, 10) == HAL_OK) {
			ADC_CurrentReading = HAL_ADC_GetValue(&hadc1);
			char str[4];
			HAL_UART_Transmit(&hlpuart1, (void *)str, sprintf(str, "%d\n", ADC_CurrentReading), 10);
		}
		
		HAL_ADC_Stop(&hadc1);
		
		// SN74HC595_TestReel();
		
    /* USER CODE END WHILE */

    /* USER CODE BEGIN 3 */
  }
  /* USER CODE END 3 */
}

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
/* USER CODE BEGIN 4 */

void ReverseRxIntoTx(void)
{
	int index = OldPos;
	for (int i = RxDataLength - 1; i >= 0; i--)
	{
		DebugTxData[i] = MainDataBuffer[index++];
	}
}

void HAL_UARTEx_RxEventCallback(UART_HandleTypeDef *huart, uint16_t Size)
{
  /* Prevent unused argument(s) compilation warning */
  UNUSED(huart);
  UNUSED(Size);

	if(huart->Instance == LPUART1)
	{
		// code borrowed heavily from a tutorial from Controllers Tech
		OldPos = NewPos; // Update the last position before copying new data
		
		if (OldPos+Size > MAIN_BUFFER_SIZE)
		{
			uint16_t BufferRemaining = MAIN_BUFFER_SIZE - OldPos; // remaining space in buffer
			memcpy(MainDataBuffer + OldPos, DebugRxBuffer, BufferRemaining); // fill remaining space in main buffer
			
			OldPos = 0; // point to front of buffer
			NewPos = Size - BufferRemaining; // mark endpoint of entry
			memcpy (MainDataBuffer, DebugRxBuffer + BufferRemaining, NewPos); // copy overflow data to front of main buffer
		}
		else
		{
			memcpy(MainDataBuffer + OldPos, DebugRxBuffer, Size);
			NewPos = Size + OldPos;
		}
			
		RxDataFlag = 1;
		RxDataLength = Size;
		
		HAL_UARTEx_ReceiveToIdle_DMA(&hlpuart1, DebugRxBuffer, RX_BUFFER_SIZE);
		__HAL_DMA_DISABLE_IT(&hdma_lpuart1_rx, DMA_IT_HT);
	}
}

void HAL_GPIO_EXTI_Rising_Callback(uint16_t GPIO_Pin)
{
	if(GPIO_Pin == GPIO_PIN_0)
	{
		// Turns LD3 on when magnet detected by hall sensor
		HAL_GPIO_WritePin(GPIOB, GPIO_PIN_5, GPIO_PIN_RESET);
	}
}
void HAL_GPIO_EXTI_Falling_Callback(uint16_t GPIO_Pin)
{
	// Turn off blinky before transferring ownership
	/* if (HAL_GPIO_ReadPin(GPIOB, BlinkyPin) == GPIO_PIN_SET)
				HAL_GPIO_WritePin(GPIOB, BlinkyPin, GPIO_PIN_RESET);
	
	if(GPIO_Pin == GPIO_PIN_1) // connected to user button 1, increments blinky pin
	{
		if (BlinkyPin == GPIO_PIN_5) // accounts for rollover
			BlinkyPin >>= 2;
		else
			BlinkyPin <<= 1; // shifts to next LED GPIO
	}
	else if(GPIO_Pin == GPIO_PIN_2) // connected to user button 2, decrements blinky pin
	{
		if (BlinkyPin == GPIO_PIN_3)
			BlinkyPin <<= 2;
		else
			BlinkyPin >>= 1;
	} */
	
	if(GPIO_Pin == GPIO_PIN_0)
	{
		// Turns LD3 on when magnet detected by hall sensor
		HAL_GPIO_WritePin(GPIOB, GPIO_PIN_5, GPIO_PIN_SET);
	}
	else if(GPIO_Pin == GPIO_PIN_1) // connected to user button 1
	{
		BlinkyEn ^= 1; // toggle whether blinky runs
	}
}

/* USER CODE END 4 */
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
