andrewge8622/PCB_Coil_WPT/Firmware/WPT_Receiver/Core/Inc/main.h

#define SR_EN_Pin GPIO_PIN_3
#define SR_EN_GPIO_Port GPIOA
#define RCLK_Pin GPIO_PIN_4
#define RCLK_GPIO_Port GPIOA
#define SRCLK_Pin GPIO_PIN_5
#define SRCLK_GPIO_Port GPIOA
#define SR_CLR_Pin GPIO_PIN_6
#define SR_CLR_GPIO_Port GPIOA
#define SER_O_Pin GPIO_PIN_7
#define SER_O_GPIO_Port GPIOA
#define VSENSE_Pin GPIO_PIN_0
#define VSENSE_GPIO_Port GPIOB
#define USER_BTN_1_Pin GPIO_PIN_1
#define USER_BTN_1_GPIO_Port GPIOB
#define USER_BTN_1_EXTI_IRQn EXTI0_1_IRQn
#define USER_BTN_2_Pin GPIO_PIN_2
#define USER_BTN_2_GPIO_Port GPIOB
#define USER_BTN_2_EXTI_IRQn EXTI2_3_IRQn
#define ISENSE_Pin GPIO_PIN_12
#define ISENSE_GPIO_Port GPIOB
#define HALL_INT_Pin GPIO_PIN_0
#define HALL_INT_GPIO_Port GPIOD
#define HALL_INT_EXTI_IRQn EXTI0_1_IRQn
#define LD1_Pin GPIO_PIN_3
#define LD1_GPIO_Port GPIOB
#define LD2_Pin GPIO_PIN_4
#define LD2_GPIO_Port GPIOB
#define LD3_Pin GPIO_PIN_5
#define LD3_GPIO_Port GPIOB
