andrewge8622/PCB_Coil_WPT/(commit log)

2020-11-12 adding Kicad files
    [Coil Driver.kicad_pcb, Coil Driver.sch]
2020-11-12 added symbols for gate driver and schottky diode, footprint for gate driver
    [DGD05473FN-7.stp]
2020-11-12 added WIMA film cap for resonant tank. Symbol is not structured well, but this seems to be a limitation of Kicad
2020-11-20 added components for buck converter and boost diode
2020-11-20 Started schematic capture. Finished first draft of input, buck, and h-bridge. Modified symbols for cleaner schematic.
    [Coil Driver.sch]
2020-11-21 moving .gitignore to hardware folder to prepare for committing firmware folder. Also modified decoupling caps for gate drivers
    [Coil Driver.sch]
2020-11-21 adding initially generated cubemx files (configured for complementary PWM on TIM1 CH3, with inserted deadtime)
2020-12-10 added micro and button to library, added microcontroller to schematic, added boxes and title block info, and annotated refdes
    [Coil Driver.sch]
2020-12-10 added a couple of GPIO in cubeMX
2020-12-10 Added power flags, passing ERC
    [Coil Driver.sch]
2020-12-10 added footprint for resettable fuse
    [16-2.STEP, Coil Driver.sch]
2020-12-25 changed WIMA cap to be standard capacitor part with new parameters
    [Coil Driver.sch]
2020-12-25 created footprint for inductor and added parameters to schematic. Added switch footprint. Added several missing STEP models. Note that updating all from library may reset paths and cause STEPs from K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
    [ABM3B.STEP, CUI_DEVICES_PJ-102AH.step, Coil Driver.kicad_pcb, Coil Driver.sch, PTS647SN50SMTR2LFS.stp, WE-TPC_4818 (rev1).stp]
2020-12-25 imported footprints into PCB document. Added user LEDs and power indication LEDs to schematic.
    [Coil Driver.kicad_pcb, Coil Driver.sch]
2020-12-27 Swapped out 8MHz crystal for 2 pin instead of 4 pin. Initial part placement (except for gate drivers/h-bridge) loosely complete. Decided board will be 4 layers to make routing of power nets easier.
    [Coil Driver.kicad_pcb, Coil Driver.sch, ECS-80-18-30-JGN-TR.STEP]
2021-01-02 completed first draft of part placement, and switching loop layout of gate drivers
    [Coil Driver.kicad_pcb, Coil Driver.sch]
2021-01-03 Added internal layers, routed power input and buck converter, and repositioned a few components. Defined PCB shape and moved to center of drawing template.
    [Coil Driver.kicad_pcb, Coil Driver.sch]
2021-01-03 Done with initial routing of microcontroller. Flipped order of extra IO exposed on header to ease routing. Added some power pours
    [Coil Driver.kicad_pcb, Coil Driver.sch]
2021-01-03 done with routing other than a few power/ground connections
    [Coil Driver.kicad_pcb]
2021-01-03 added ground vias
    [Coil Driver.kicad_pcb]
2021-01-03 Added 12V and 3.3V vias, full connectivity. Passes DRC.
    [Coil Driver.kicad_pcb]
2021-01-03 Positioned all designators and added logo library
    [Coil Driver.kicad_pcb, Coil Driver.sch]
2021-01-16 added ground stitching vias throughout board, and via fence around switching region. More or less ready to go.
    [Coil Driver.kicad_pcb]
2021-01-16 fixed DRCs caused by new vias. oops.
    [Coil Driver.kicad_pcb]
2021-01-16 added silkscreen label and rev
    [Coil Driver.kicad_pcb]
2021-05-22 committing final changes to coil driver, and creating new kicad folder for receiver
    [Coil Driver.kicad_pcb, Coil Driver.sch, WPT Receiver.kicad_pcb, WPT Receiver.sch]
2021-05-22 created libraries that could be linked into new receiver project. Added STM32G031C6U6 and small Nexperia SOT323 FET to library
2021-05-22 Added input resonant tank, bridge rectifier, and buck to schematic for receiver
    [WPT Receiver.sch]
2021-05-22 updated title block parameters for both schematic. In receiver, modified symbol of STM32, added to schematic and also added crystal, decoupling caps, and buttons
    [Coil Driver.sch, WPT Receiver.sch]
2021-06-05 Added placeholder text for remaining parts of board (hall sensor, temp sensor, current sense, LEDs, etc.)
    [WPT Receiver.sch]
2021-06-05 started pin selection in CubeMX
2021-06-06 Created symbols for INA180 and Hall sensor. Added to schematic and implemented supporting circuitry. Added background color to old tag connect symbol
    [WPT Receiver.sch]
2021-06-06 Added most of pinout for STM32G0, as well as measurement circuit for voltage sense. Added implementation for one shift reg.
    [WPT Receiver.sch]
2021-06-06 Removed a bunch of ground vias (especially stitching around switching area) that were causing discontinuity in 12V pour in power layer
    [Coil Driver.kicad_pcb]
2021-06-09 added and wired up shift registers, added debug headers, and modified pinout slightly. Cleaned up ERC and added power flags. Design passes ERC, ready to assign footprints
    [WPT Receiver.sch]
2021-07-22 Added footprint associations, as well as a few MPN/VDC parameters and an RC filter footprint on current sense line. Imported footprints into pcb
    [WPT Receiver.kicad_pcb, WPT Receiver.sch]
2021-07-22 Added an MPN to electrolytic caps in coil driver. Added debug LEDs to 3 pins on receiver micro
    [Coil Driver.sch, WPT Receiver.sch]
2021-07-23 started very rough part placement. Rounded board outline edges.
    [WPT Receiver.kicad_pcb]
2021-07-27 Positioned non-power components, and routed most signals for peripherals other than shift regs/drivers. Added folder for 3D models for switch and crystal
    [ECS-80-18-30-JGN-TR.STEP, PTS647SN50SMTR2LFS.stp, WPT Receiver.kicad_pcb, WPT Receiver.sch]
2021-07-27 Routed all signals for shift regs and LEDs.
    [WPT Receiver.kicad_pcb]
2021-07-30 Added routing for power input region (including buck) and a few other remaining signals. All signals now routed other than ground
    [WPT Receiver.kicad_pcb, WPT Receiver.sch]
2021-07-30 added ground vias for all signals, and ground pour on bottom layer
    [WPT Receiver.kicad_pcb]
2021-07-30 Added tons of ground vias for stiching and to better connect islands. Added logo library and added to board
    [WPT Receiver.kicad_pcb]
2021-07-31 Added silkscreen labels to headers, positioned all designators. First draft complete
    [WPT Receiver.kicad_pcb]
2021-07-31 Fixed DRC errors. Added some silkscreen and generated gerbers and drill file
    [WPT Receiver-B_Cu.gbr, WPT Receiver-B_Mask.gbr, WPT Receiver-B_Paste.gbr, WPT Receiver-B_SilkS.gbr, WPT Receiver-Edge_Cuts.gbr, WPT Receiver-F_Cu.gbr, WPT Receiver-F_Mask.gbr, WPT Receiver-F_Paste.gbr]
2021-07-31 small change to soldermask
    [WPT Receiver-B_Cu.gbr, WPT Receiver-B_Mask.gbr, WPT Receiver-B_Paste.gbr, WPT Receiver-B_SilkS.gbr, WPT Receiver-Edge_Cuts.gbr, WPT Receiver-F_Cu.gbr, WPT Receiver-F_Mask.gbr, WPT Receiver-F_Paste.gbr]
2021-07-31 Copied in old inductor coil files and made updates for this round of testing. Generated Gerbers for all boards.
    [Coil Driver-B_Cu.gbr, Coil Driver-B_Mask.gbr, Coil Driver-B_Paste.gbr, Coil Driver-B_SilkS.gbr, Coil Driver-Edge_Cuts.gbr, Coil Driver-F_Cu.gbr, Coil Driver-F_Mask.gbr, Coil Driver-F_Paste.gbr]
2021-09-29 Generated initial files using CubeMX and imported into Keil. Added a blinky, and also configured shift reg OE to high to avoid floating outputs
    [WPT_Receiver.ioc, main.c, main.h]
2021-09-29 Added code to read user buttons using interrupts, and toggle LEDs
2021-09-29 Added global static variable for which pin is showing blinky. Added logic within interrupt callback to increment/decrement pin based on button inputs
2021-10-01 Updated settings in cube. Wrote new interrupt routine (both rising and falling) for hall sensor output to enable LD3 when magnet present. Removed moving blinky, and instead made UB1 enable/disable bl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
2021-10-06 modified IOC file to enable DMA interrupts on IDLE (for LPUART1). Implemented variable length input on UART RX using DMA IDLE signal. Added function to reverse and echo received data to prove receive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
    [WPT_Receiver.ioc, main.c]
2021-10-14 Modified Cube settings to enable timer2, channel4 as PWM output on SR_EN pin, for dimming of LEDs. Implemented enable/disable/PWM functions, modified init function, and got ClearAll function mostly w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
2021-10-15 started implementing ADC function. Transferring VSENSE channel to terminal over UART appears to work fine using sprintf.
2021-10-19 Updated pins, including labels, in Cube to match schematic. Wrote blinky to verify board MCU is operating. Note that boot resistor silkscreen labels were swapped, so MCU did not start up properly unt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
    [WPT_Transmitter.ioc, main.c, main.h]
2021-10-19 Modified Cube settings again to enable interrupts on user buttons. Wrote interrupt callback so that user buttons can be used to turn on/off an LED, which will shortly be modified to control GD_EN pin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
    [WPT_Transmitter.ioc, main.c, main.h]
